dungcathanglthtn261/dungcathanglthtn261/docs/Đề tài.docx

Tên đề tài: Thiết bị đo độ ẩm đất và tự động tưới cây (Smart Irrigation System)

1. Mục tiêu đề tài

Xây dựng hệ thống nhúng điều khiển tưới cây tự động dựa trên vi điều khiển STM32 (ARM Cortex-M), giám sát độ ẩm đất trong khoảng từ 0% đến 100%, tự động kích hoạt/ngừng máy bơm theo ngưỡng cài đặt, hỗ trợ giám sát tại chỗ qua LCD và truyền dữ liệu giám sát từ xa về máy tính qua cổng nối tiếp UART[1][4].

2. Thiết kế phần cứng & Khối ngoại vi (Hardware Prototype)

- Vi điều khiển trung tâm: STM32F4 (hoặc STM32F103 Blue Pill)[4].
- Khối cảm biến (Sensor Interface): Cảm biến độ ẩm đất (Soil Moisture Sensor) đọc giá trị điện áp tương tự qua bộ chuyển đổi ADC[1][4].
- Khối hiển thị (Display): Màn hình LCD 16x02 (hoặc LCD 7-segment) hiển thị độ ẩm hiện tại (%), ngưỡng Set point, chế độ hoạt động và trạng thái máy bơm[1][4].
- Khối giao tiếp người dùng (Buttons): Các nút nhấn được xử lý chống dội (Debounce)[1][4]:
- Nút MODE: Chuyển đổi giữa chế độ Tự động (Auto) và Thủ công (Manual)[4].
- Nút UP / DOWN: Cài đặt ngưỡng độ ẩm tự động tưới (Set point: 0% – 100%)[4].
- Nút PUMP: Bật/Tắt máy bơm thủ công khi ở chế độ Manual[4].
- Khối chấp hành (Actuator): Module Relay điều khiển bật/tắt van từ hoặc máy bơm nước[4].
- Khối truyền thông ngoại vi (Communication): Cổng nối tiếp USART/UART gửi dữ liệu giám sát độ ẩm và trạng thái bơm lên máy tính (sử dụng phần mềm Terminal như Tera Term / Hercules)[1][5].

3. Yêu cầu chức năng chi tiết (Functional Requirements)

- Lấy mẫu & Đo đạc: Đọc giá trị độ ẩm từ cảm biến qua ADC định kỳ mỗi 1000 ms, quy đổi sang tỷ lệ phần trăm (0% – 100%, độ phân giải 1%)[4].
- Thuật toán điều khiển:
- Chế độ Auto: Tự động kích hoạt Relay bật máy bơm khi độ ẩm đất thấp hơn ngưỡng Set point và tắt máy bơm khi độ ẩm đạt ngưỡng[4].
- Chế độ Manual: Bật/Tắt máy bơm trực tiếp thông qua nút nhấn PUMP, không phụ thuộc vào giá trị cảm biến[4].
- Hiển thị tại chỗ: Cập nhật liên tục độ ẩm hiện tại, trạng thái máy bơm (ON/OFF), ngưỡng cài đặt và chế độ (AUTO/MAN) lên màn hình LCD[4].
- Truyền dữ liệu lên PC: Định kỳ truyền gói tin dữ liệu qua UART về máy tính theo định dạng chuẩn (Ví dụ: SOIL: 45% | SET: 60% | MODE: AUTO | PUMP: ON) để ghi log và giám sát[1][5].

4. Kiến trúc phần mềm & Hệ điều hành thời gian thực (FreeRTOS)

Để đáp ứng tiêu chuẩn thiết kế mô-đun hóa, dễ tái sử dụng và quản lý đa nhiệm[1]:

- Phân tầng mã nguồn (Layered Architecture)[1][7]:
- Driver / HAL Layer: Cấu hình thanh ghi / thư viện ngoại vi STM32 (GPIO, ADC, USART, SysTick)[7][8].
- Middleware / Abstraction Layer: Thiết kế các file mảng mô-đun .h/.c độc lập cho từng ngoại vi (soil_sensor.h/.c, lcd16x02.h/.c, button.h/.c, relay_pump.h/.c, uart_comm.h/.c)[6][7].
- Application Layer: Chứa thuật toán điều khiển chính và quản lý máy trạng thái (State Machine)[7].
- Tổ chức tác vụ FreeRTOS (Recommended)[1][2]:
- Task_SensorRead (Chu kỳ 1000 ms): Đọc ADC cảm biến độ ẩm đất và lọc nhiễu[4].
- Task_ButtonProcess (Chu kỳ 20 ms): Quét trạng thái nút nhấn, chống dội và cập nhật chế độ/ngưỡng[4].
- Task_Control (Chu kỳ 100 ms): Thực thi thuật toán so sánh ngưỡng điều khiển Relay bơm[4].
- Task_Display (Chu kỳ 200 ms): Cập nhật thông số lên màn hình LCD 16x02[4].
- Task_UART_Tx (Chu kỳ 1000 ms): Định dạng và gửi gói tin giám sát qua UART về máy tính[1][5].

5. Yêu cầu sản phẩm bàn giao (Deliverables)

- Báo cáo đồ án: Soạn thảo bằng MS Word hoặc LaTeX[3].
- Mô phỏng: Sơ đồ mạch và chương trình mô phỏng hoàn chỉnh trên Proteus Simulation[3][4].
- Mô hình thực nghiệm: Thi công mạch thực tế trên Breadboard hoặc mạch PCB[3][4].
