dungcathanglthtn261/dungcathanglthtn261/docs/General requirements.pdf

Student can suggest a project; the general requirements are as follow: The system has a display (character LCD, OLED …)
The system has buttons.
The system interface with sensor (temperature, humidity…) or external module like RFID reader.
The system needs to store information to SDCARD or communicate with external device (computer via serial port, server via WIFI).
Software is divided in to layers, with design-for-reuse in mind.
Using FreeRTOS is recommended.
