dungcathanglthtn261/dungcathanglthtn261/docs/block-diagram/Blockdiagram.drawio.png

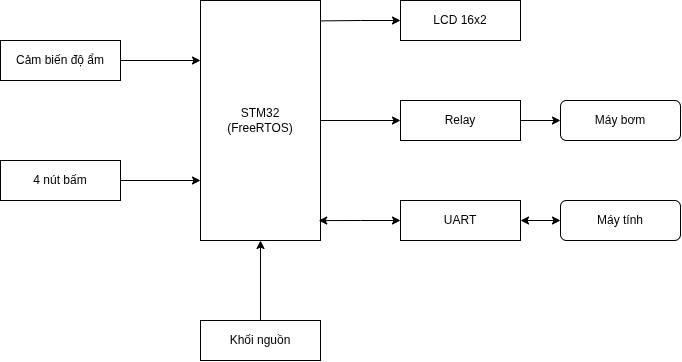
docs/block-diagram/Blockdiagram.drawio.png
