dungcathanglthtn261/dungcathanglthtn261/docs/flowcharts/0_main.png

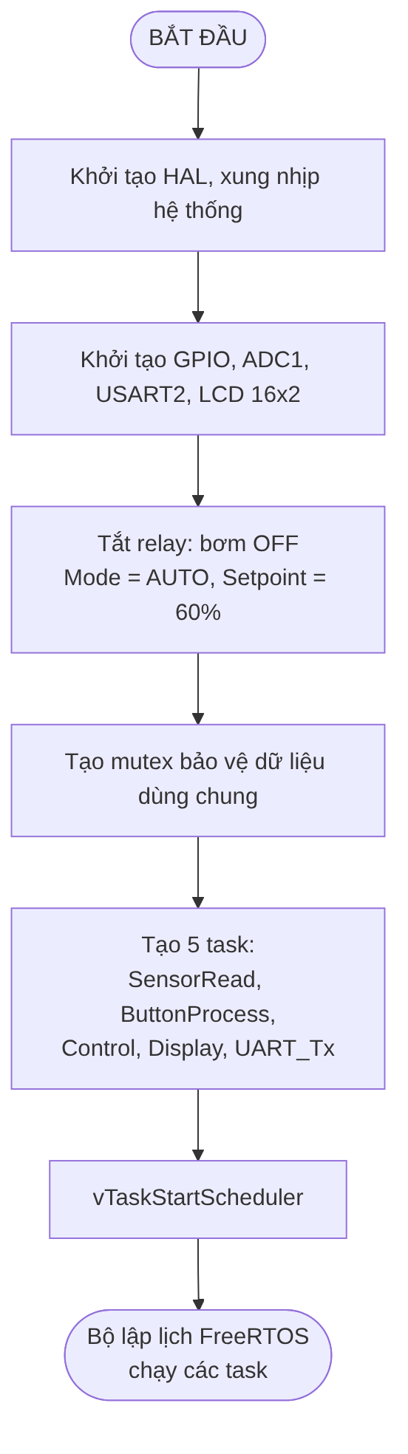
docs/flowcharts/0_main.png
