dungcathanglthtn261/dungcathanglthtn261/docs/flowcharts/1_sensor.png

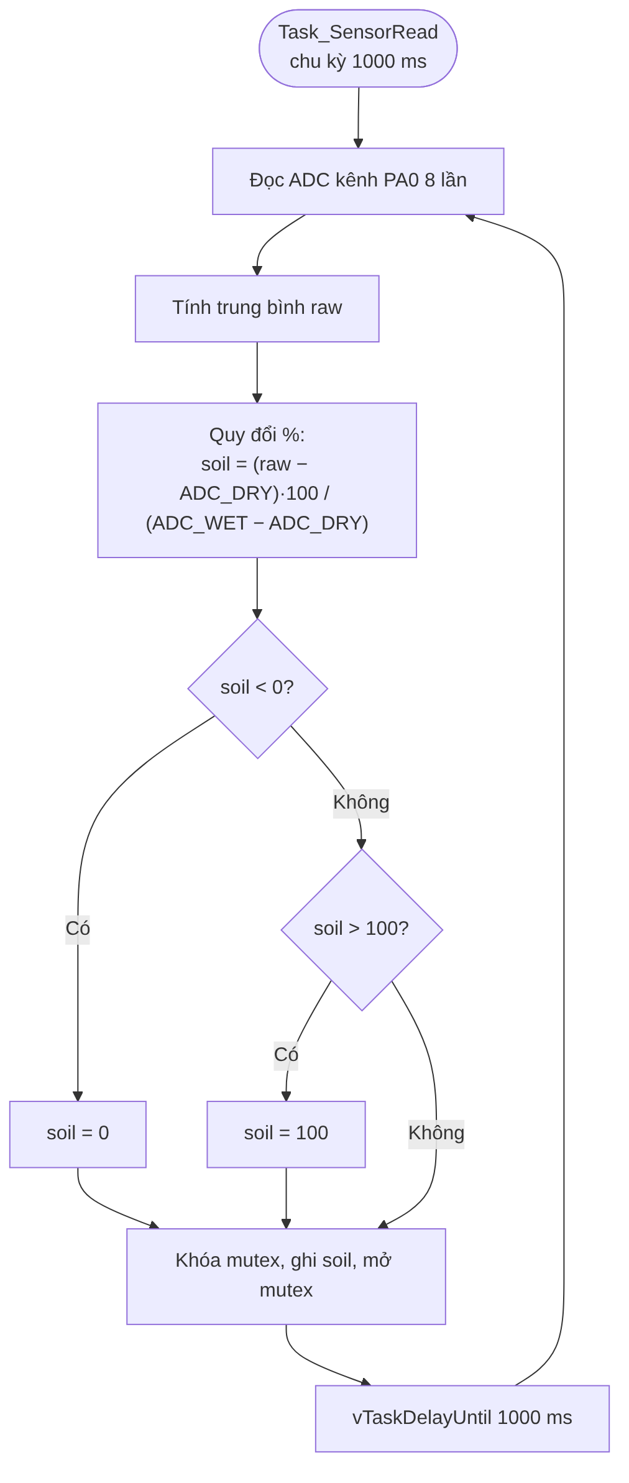
docs/flowcharts/1_sensor.png
