dungcathanglthtn261/dungcathanglthtn261/docs/flowcharts/2_button.png

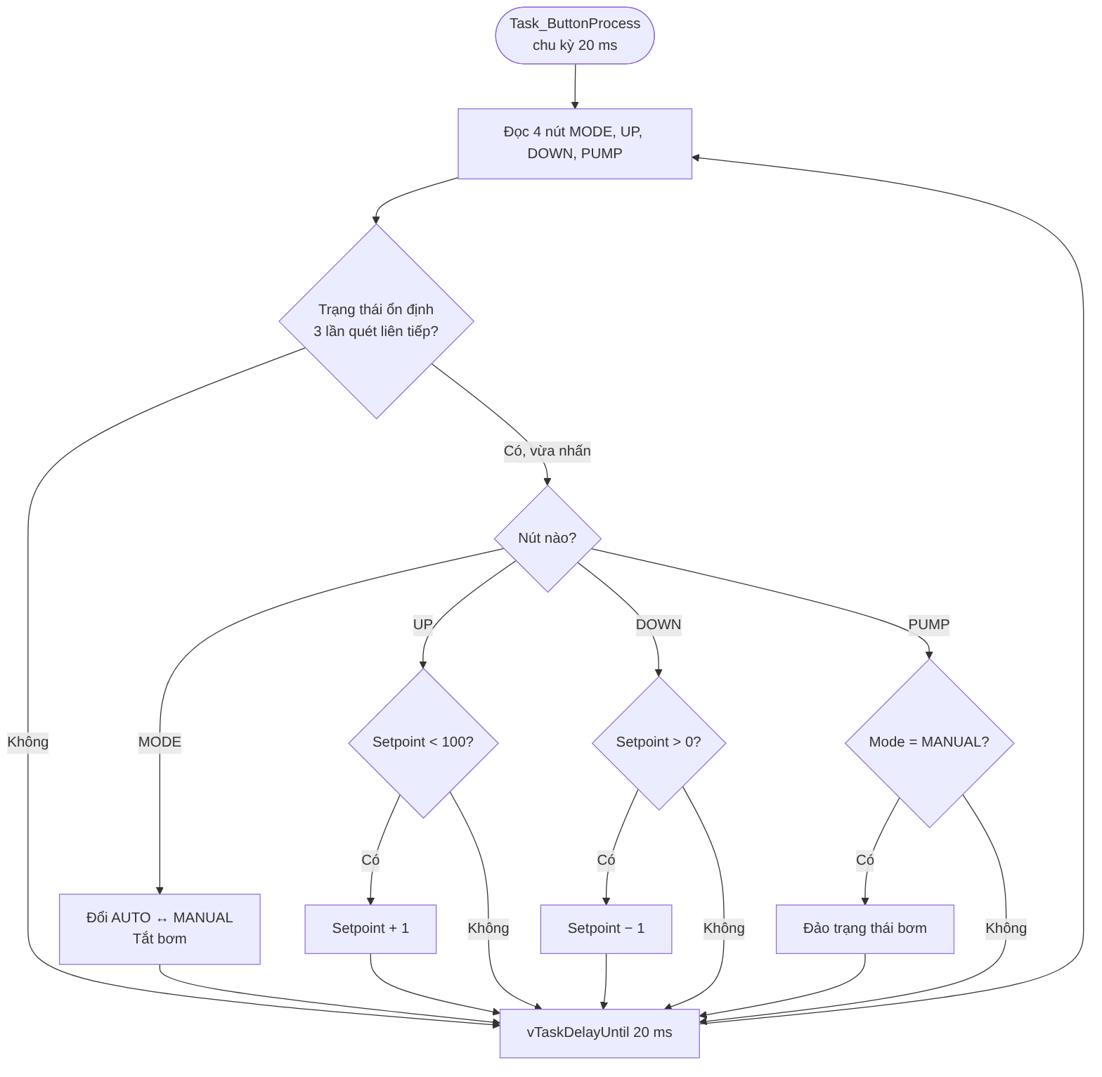
docs/flowcharts/2_button.png
