dungcathanglthtn261/dungcathanglthtn261/docs/flowcharts/3_control.png

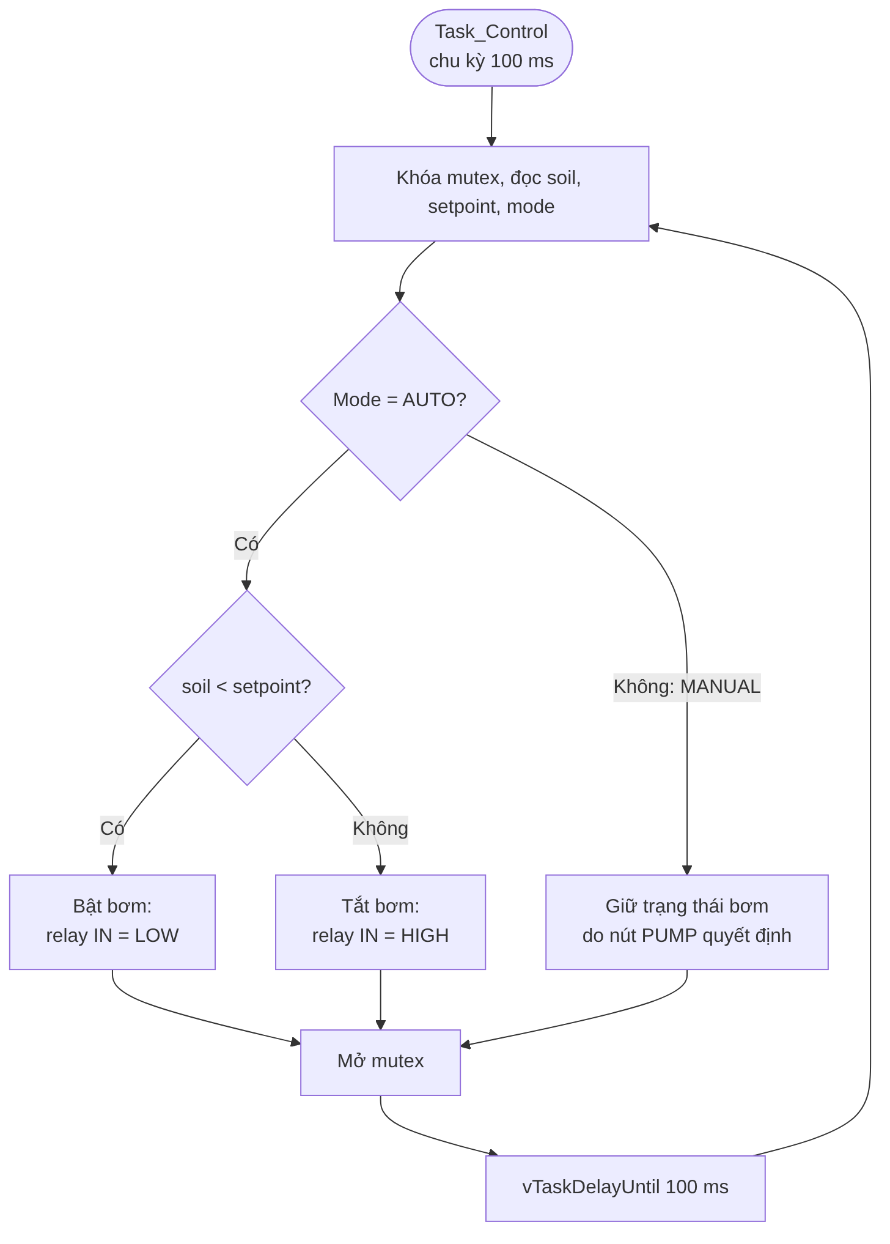
docs/flowcharts/3_control.png
