dungcathanglthtn261/dungcathanglthtn261/docs/flowcharts/4_display.png

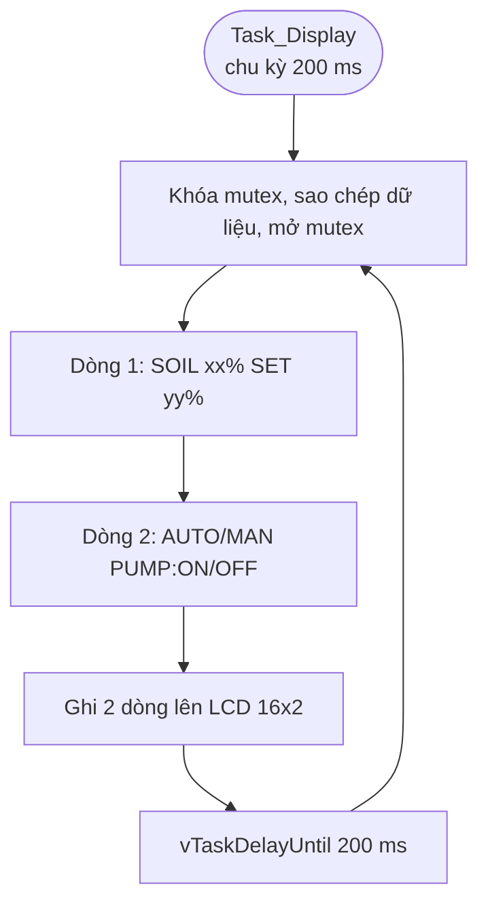
docs/flowcharts/4_display.png
