dungcathanglthtn261/dungcathanglthtn261/docs/flowcharts/5_uart.png

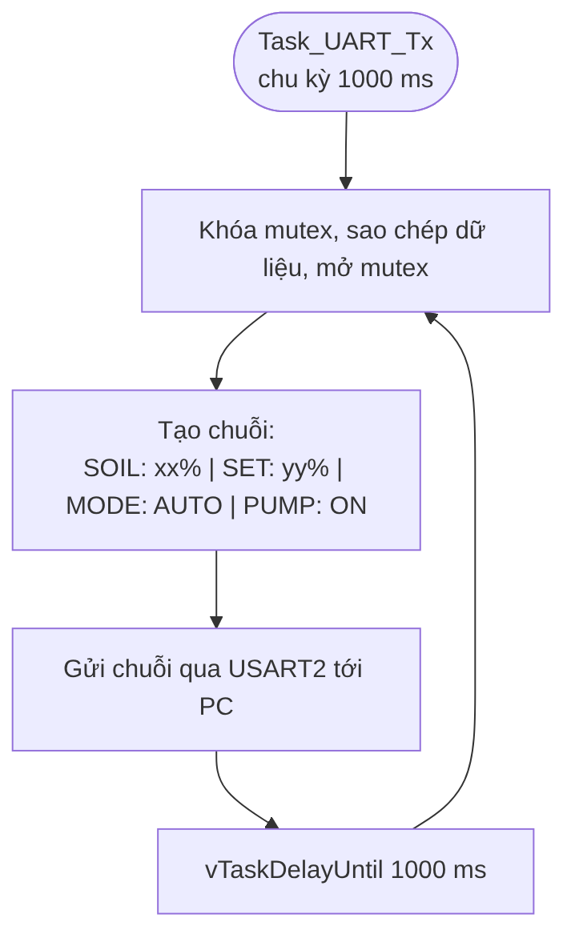
docs/flowcharts/5_uart.png
