dungcathanglthtn261/dungcathanglthtn261/hardware/images/pcb_bottom_gnd.png

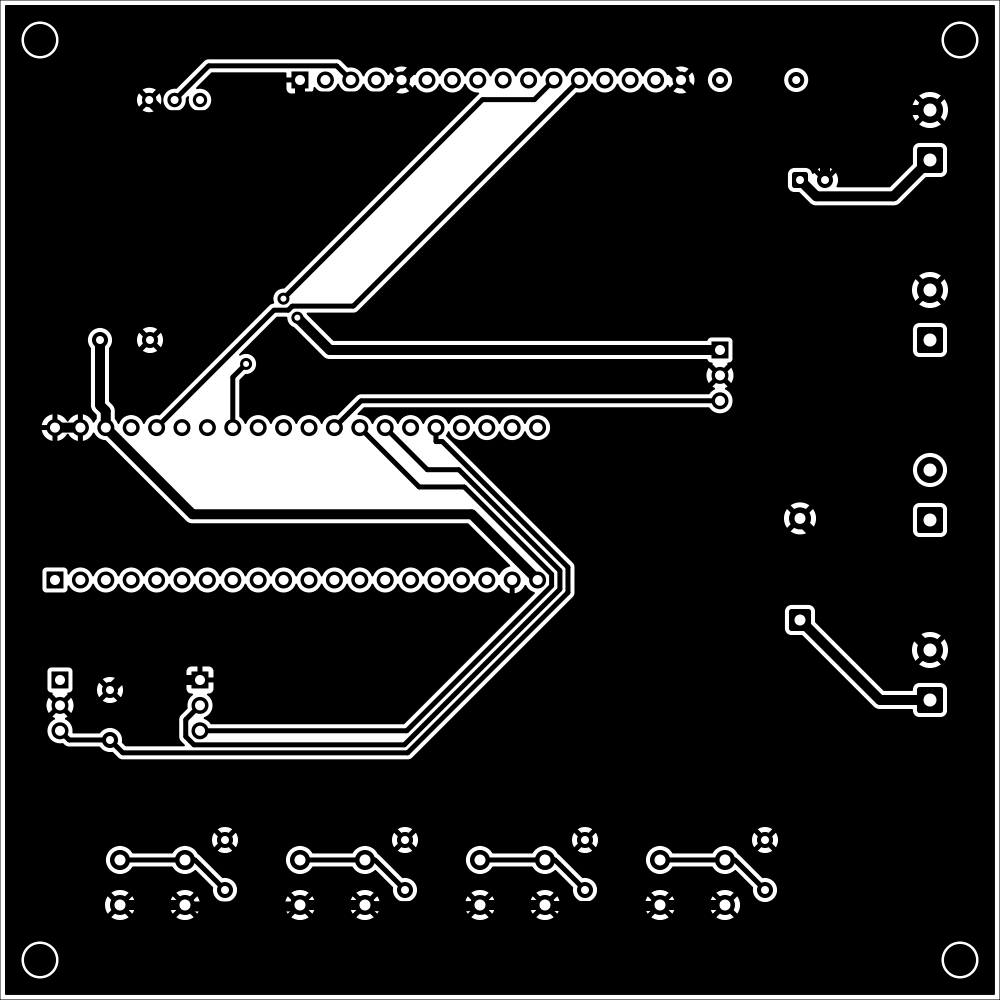
hardware/images/pcb_bottom_gnd.png
