dungcathanglthtn261/dungcathanglthtn261/hardware/images/schematic_preview.png

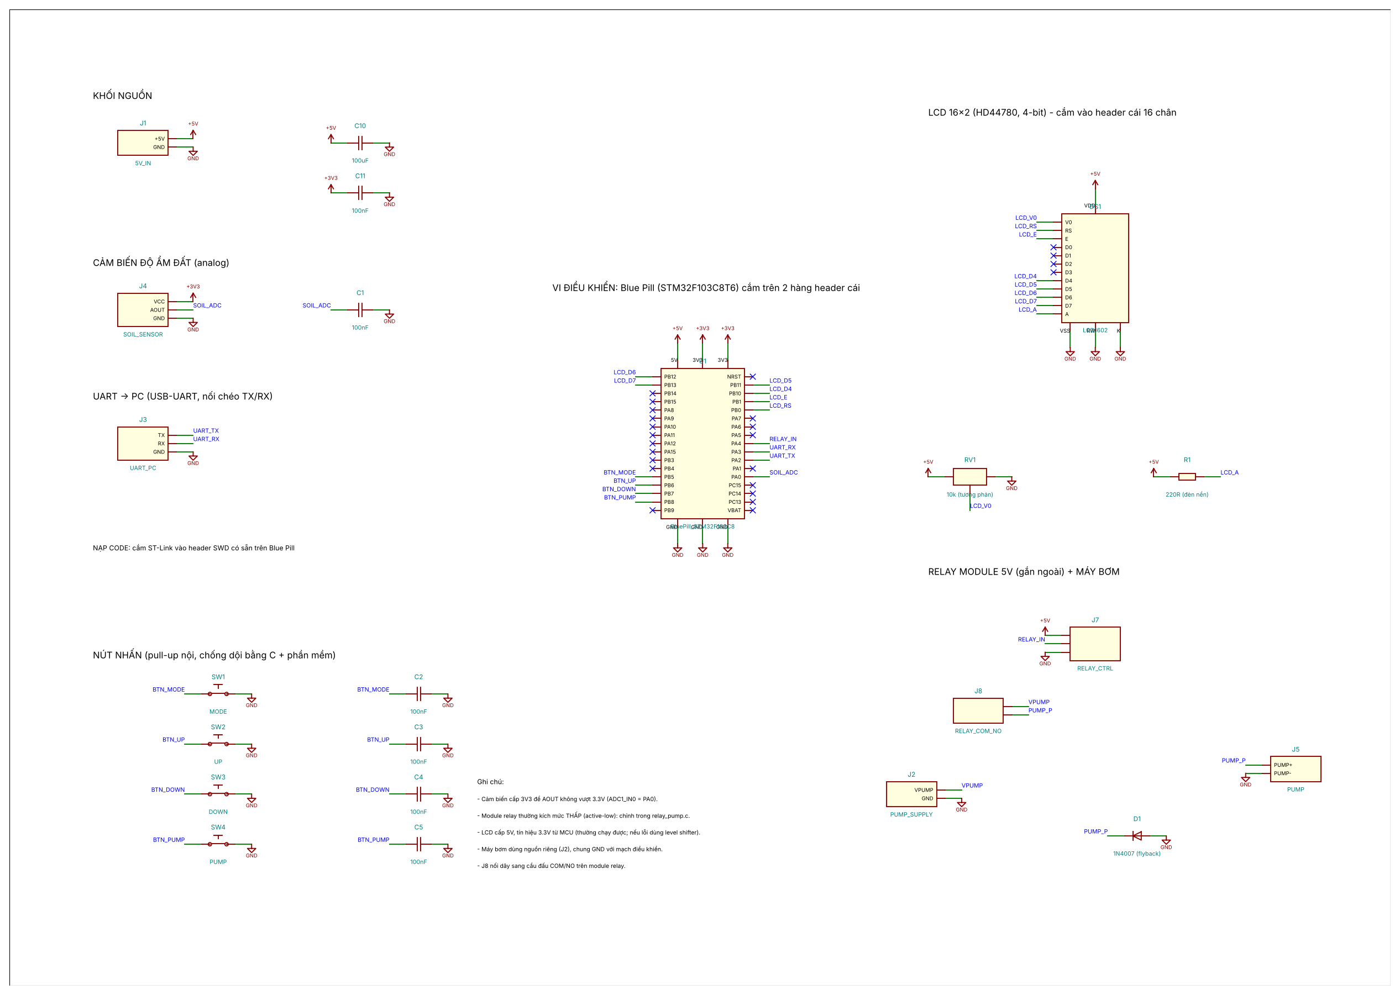
hardware/images/schematic_preview.png
