dungcathanglthtn261/dungcathanglthtn261/docs/test/Kịch bản kiểm thử.xlsx

Sheet: Tổng hợp
TỔNG HỢP KẾT QUẢ KIỂM THỬ
Tự tính từ sheet "Kịch bản test" – không cần điền.
Kịch bản | Số bước | Đã điền | Đạt | Không đạt | Kết luận
Chế độ AUTO | 4 | 0 | 0 | 0 | Chưa test xong
Chế độ MANUAL | 5 | 0 | 0 | 0 | Chưa test xong
Đổi ngưỡng | 4 | 0 | 0 | 0 | Chưa test xong
Tổng | 13 | 0 | 0 | 0 | Chưa test xong
Môi trường test: | Mokxi (bluepill) / Mạch thật – ghi rõ
Người test / ngày:

Sheet: Kịch bản test
KỊCH BẢN KIỂM THỬ – SMART IRRIGATION SYSTEM (mô phỏng Mokxi / mạch thật)
Ô nền vàng là ô cần điền. Cột "Đạt?" chọn từ danh sách (Đạt / Không đạt). Ngưỡng mặc định khi khởi động: 60%, chế độ AUTO.
Mã | Kịch bản | Bước | Thao tác | Kết quả mong đợi | Kết quả thực tế | Đạt? | Ảnh minh chứng | Ghi chú
KB1 – Chế độ AUTO: Kiểm tra thuật toán điều khiển chính
KB1-1 | Chế độ AUTO | 1 | Bấm Run, giữ ngưỡng mặc định 60% | LCD hiện "AUTO"; Serial in đúng 1 dòng/giây |  |  | Không bắt buộc
KB1-2 | Chế độ AUTO | 2 | Chỉnh cảm biến về đất khô (độ ẩm < 60%) | Trong ~1 s: relay đóng, bơm chạy; LCD và Serial báo PUMP: ON |  |  | Bắt buộc: LCD + Serial
KB1-3 | Chế độ AUTO | 3 | Chỉnh cảm biến về đất ướt (độ ẩm ≥ 60%) | Bơm tắt; LCD và Serial báo PUMP: OFF |  |  | Bắt buộc: LCD + Serial
KB1-4 | Chế độ AUTO | 4 | Bấm nút PUMP | Không có gì thay đổi (ở AUTO nút PUMP bị bỏ qua) |  |  | Không bắt buộc
KB2 – Chế độ MANUAL: Kiểm tra điều khiển tay và chuyển chế độ
KB2-1 | Chế độ MANUAL | 1 | Ở AUTO khi bơm đang chạy, bấm MODE | Bơm tắt ngay; LCD "MAN"; Serial MODE: MANUAL |  |  | Bắt buộc
KB2-2 | Chế độ MANUAL | 2 | Bấm PUMP | Bơm chạy |  |  | Không bắt buộc
KB2-3 | Chế độ MANUAL | 3 | Chỉnh đất về ướt | Bơm VẪN chạy (MANUAL bỏ qua cảm biến) |  |  | Bắt buộc
KB2-4 | Chế độ MANUAL | 4 | Bấm PUMP | Bơm tắt |  |  | Không bắt buộc
KB2-5 | Chế độ MANUAL | 5 | Bấm MODE | Quay lại AUTO; bơm được tính lại theo độ ẩm |  |  | Không bắt buộc
KB3 – Đổi ngưỡng: Kiểm tra nút UP/DOWN và ảnh hưởng của ngưỡng lên điều khiển
KB3-1 | Đổi ngưỡng | 1 | Ở AUTO, chỉnh độ ẩm ~50%, ngưỡng 60% | Bơm chạy (50 < 60) |  |  | Bắt buộc (ảnh "trước")
KB3-2 | Đổi ngưỡng | 2 | Bấm DOWN đến khi ngưỡng còn 49% | Mỗi lần bấm giảm đúng 1%; ngưỡng xuống dưới độ ẩm thì bơm tự tắt |  |  | Bắt buộc (ảnh "sau")
KB3-3 | Đổi ngưỡng | 3 | Bấm UP lên lại 55% | Bơm chạy trở lại |  |  | Không bắt buộc
KB3-4 | Đổi ngưỡng | 4 | Bấm UP liên tục tới 100% rồi bấm thêm; làm tương tự DOWN về 0% | Ngưỡng dừng ở 100% và 0%, không vượt quá |  |  | Không bắt buộc

Sheet: Số liệu mạch thật
SỐ LIỆU ĐO TRÊN MẠCH THẬT (GĐ4) – dùng cho phần sai số trong báo cáo
Ô nền vàng: điền khi đo. Cột xám tự tính. Dòng "Ví dụ" chỉ minh họa cách điền – xóa đi khi có số liệu thật.
Hằng số hiệu chuẩn
ADC_DRY (đất khô → 0%) | 3164 | Nguồn: hằng số trong sketch.ino (theo cảm biến mô phỏng: 2.55 V khô, 1.27 V ướt). Thay bằng giá trị đo khi hiệu chuẩn.
ADC_WET (đất ướt → 100%) | 1576
Điện áp tham chiếu ADC (V) | 3.3
Độ phân giải ADC (mức) | 4095
Lần đo | Kịch bản | Trạng thái đất | Điện áp AOUT đo (V) | Giá trị ADC (tính) | Độ ẩm tính theo công thức (%) | Độ ẩm hệ thống hiển thị (%) | Sai số (%) | Thời gian đáp ứng (s) | Ghi chú
Ví dụ | Chế độ AUTO | Đất khô | 2.4 | 2978 | 11.7 | 12 | 0.3 | 1 | Dòng minh họa – xóa khi có số liệu thật
1
2
3
4
5
6
7
8
9
10
11
12
13
14
15
Sai số trung bình (%)
Thời gian đáp ứng trung bình (s)
(Trung bình không tính dòng "Ví dụ".)
