dungcathanglthtn261/dungcathanglthtn261/hardware/kicad/smart_irrigation.kicad_pcb

## KiCad design hardware/kicad/smart_irrigation.kicad_pcb (2026-11-06)

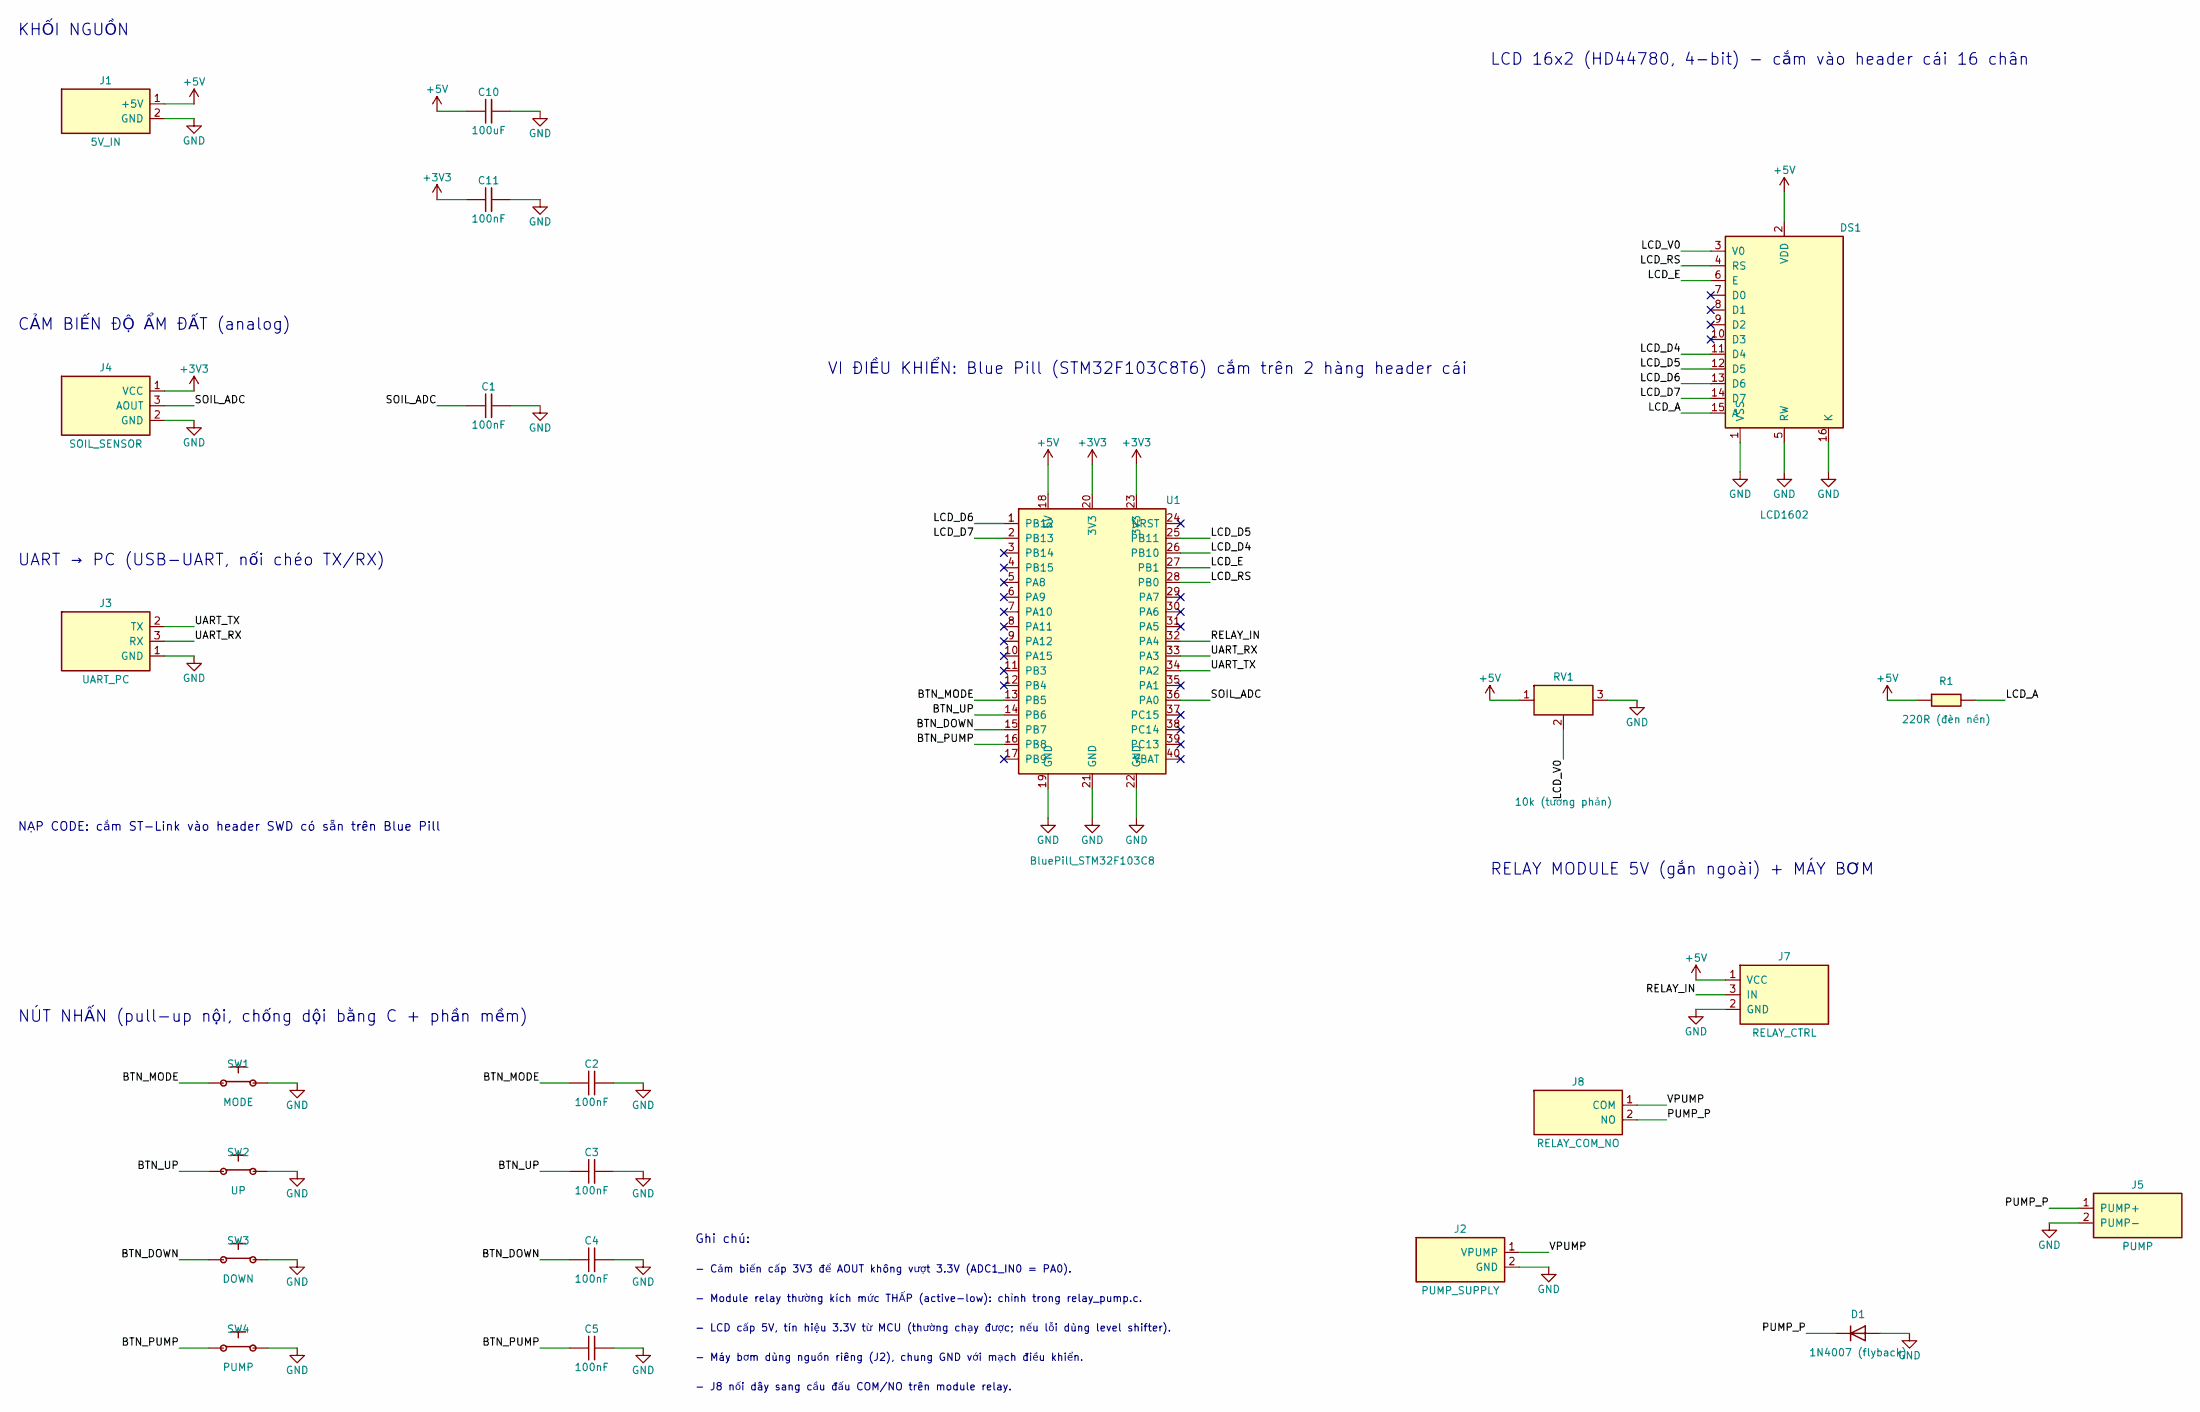
[picture p11: schematic smart_irrigation.kicad_sch, Smart Irrigation System - Schematic]

Parts:
C1, C2, C3, C4, C5, C11: 100nF; C_Disc_D5.0mm_W2.5mm_P5.00mm
C10: 100uF; CP_Radial_D6.3mm_P2.50mm
D1: 1N4007 (flyback); D_DO-41_SOD81_P10.16mm_Horizontal
DS1: LCD1602; PinSocket_1x16_P2.54mm_Vertical
J1: 5V_IN; TerminalBlock_Phoenix_MKDS-1,5-2_1x02_P5.00mm_Horizontal
J2: PUMP_SUPPLY; TerminalBlock_Phoenix_MKDS-1,5-2_1x02_P5.00mm_Horizontal
J3: UART_PC; PinHeader_1x03_P2.54mm_Vertical
J4: SOIL_SENSOR; PinHeader_1x03_P2.54mm_Vertical
J5: PUMP; TerminalBlock_Phoenix_MKDS-1,5-2_1x02_P5.00mm_Horizontal
J7: RELAY_CTRL; PinHeader_1x03_P2.54mm_Vertical
J8: RELAY_COM_NO; TerminalBlock_Phoenix_MKDS-1,5-2_1x02_P5.00mm_Horizontal
R1: 220R (đèn nền); R_Axial_DIN0207_L6.3mm_D2.5mm_P7.62mm_Horizontal
RV1: 10k (tương phản); Potentiometer_Bourns_3296W_Vertical
SW1: MODE; SW_PUSH_6mm
SW2: UP; SW_PUSH_6mm
SW3: DOWN; SW_PUSH_6mm
SW4: PUMP; SW_PUSH_6mm
U1: BluePill_STM32F103C8; BluePill_Socket

Connections:
+3V3: C11.1, J4.1 (VCC), U1.20 (3V3), U1.23 (3V3)
+5V: C10.1, DS1.2 (VDD), J1.1 (+5V), J7.1 (VCC), R1.1, RV1.1, U1.18 (5V)
BTN_DOWN: C4.1, SW3.1, U1.15 (PB7)
BTN_MODE: C2.1, SW1.1, U1.13 (PB5)
BTN_PUMP: C5.1, SW4.1, U1.16 (PB8)
BTN_UP: C3.1, SW2.1, U1.14 (PB6)
GND: C1.2, C2.2, C3.2, C4.2, C5.2, C10.2, C11.2, D1.2 (A), DS1.1 (VSS), DS1.5 (RW), DS1.16 (K), J1.2 (GND), J2.2 (GND), J3.1 (GND), J4.2 (GND), J5.2 (PUMP-), J7.2 (GND), RV1.3, SW1.2, SW2.2, SW3.2, SW4.2, U1.19 (GND), U1.21 (GND), U1.22 (GND)
LCD_A: DS1.15 (A), R1.2
LCD_D4: DS1.11 (D4), U1.26 (PB10)
LCD_D5: DS1.12 (D5), U1.25 (PB11)
LCD_D6: DS1.13 (D6), U1.1 (PB12)
LCD_D7: DS1.14 (D7), U1.2 (PB13)
LCD_E: DS1.6 (E), U1.27 (PB1)
LCD_RS: DS1.4 (RS), U1.28 (PB0)
LCD_V0: DS1.3 (V0), RV1.2 (W)
PUMP_P: D1.1 (K), J5.1 (PUMP+), J8.2 (NO)
RELAY_IN: J7.3 (IN), U1.32 (PA4)
SOIL_ADC: C1.1, J4.3 (AOUT), U1.36 (PA0)
UART_RX: J3.3 (RX), U1.33 (PA3)
UART_TX: J3.2 (TX), U1.34 (PA2)
VPUMP: J2.1 (VPUMP), J8.1 (COM)

Notes on the sheet:
KHỐI NGUỒN
CẢM BIẾN ĐỘ ẨM ĐẤT (analog)
UART → PC (USB-UART, nối chéo TX/RX)
NẠP CODE: cắm ST-Link vào header SWD có sẵn trên Blue Pill
NÚT NHẤN (pull-up nội, chống dội bằng C + phần mềm)
VI ĐIỀU KHIỂN: Blue Pill (STM32F103C8T6) cắm trên 2 hàng header cái
LCD 16x2 (HD44780, 4-bit) - cắm vào header cái 16 chân
RELAY MODULE 5V (gắn ngoài) + MÁY BƠM
Ghi chú:
- Cảm biến cấp 3V3 để AOUT không vượt 3.3V (ADC1_IN0 = PA0).
- Module relay thường kích mức THẤP (active-low): chỉnh trong relay_pump.c.
- LCD cấp 5V, tín hiệu 3.3V từ MCU (thường chạy được; nếu lỗi dùng level shifter).
- Máy bơm dùng nguồn riêng (J2), chung GND với mạch điều khiển.
- J8 nối dây sang cầu đấu COM/NO trên module relay.

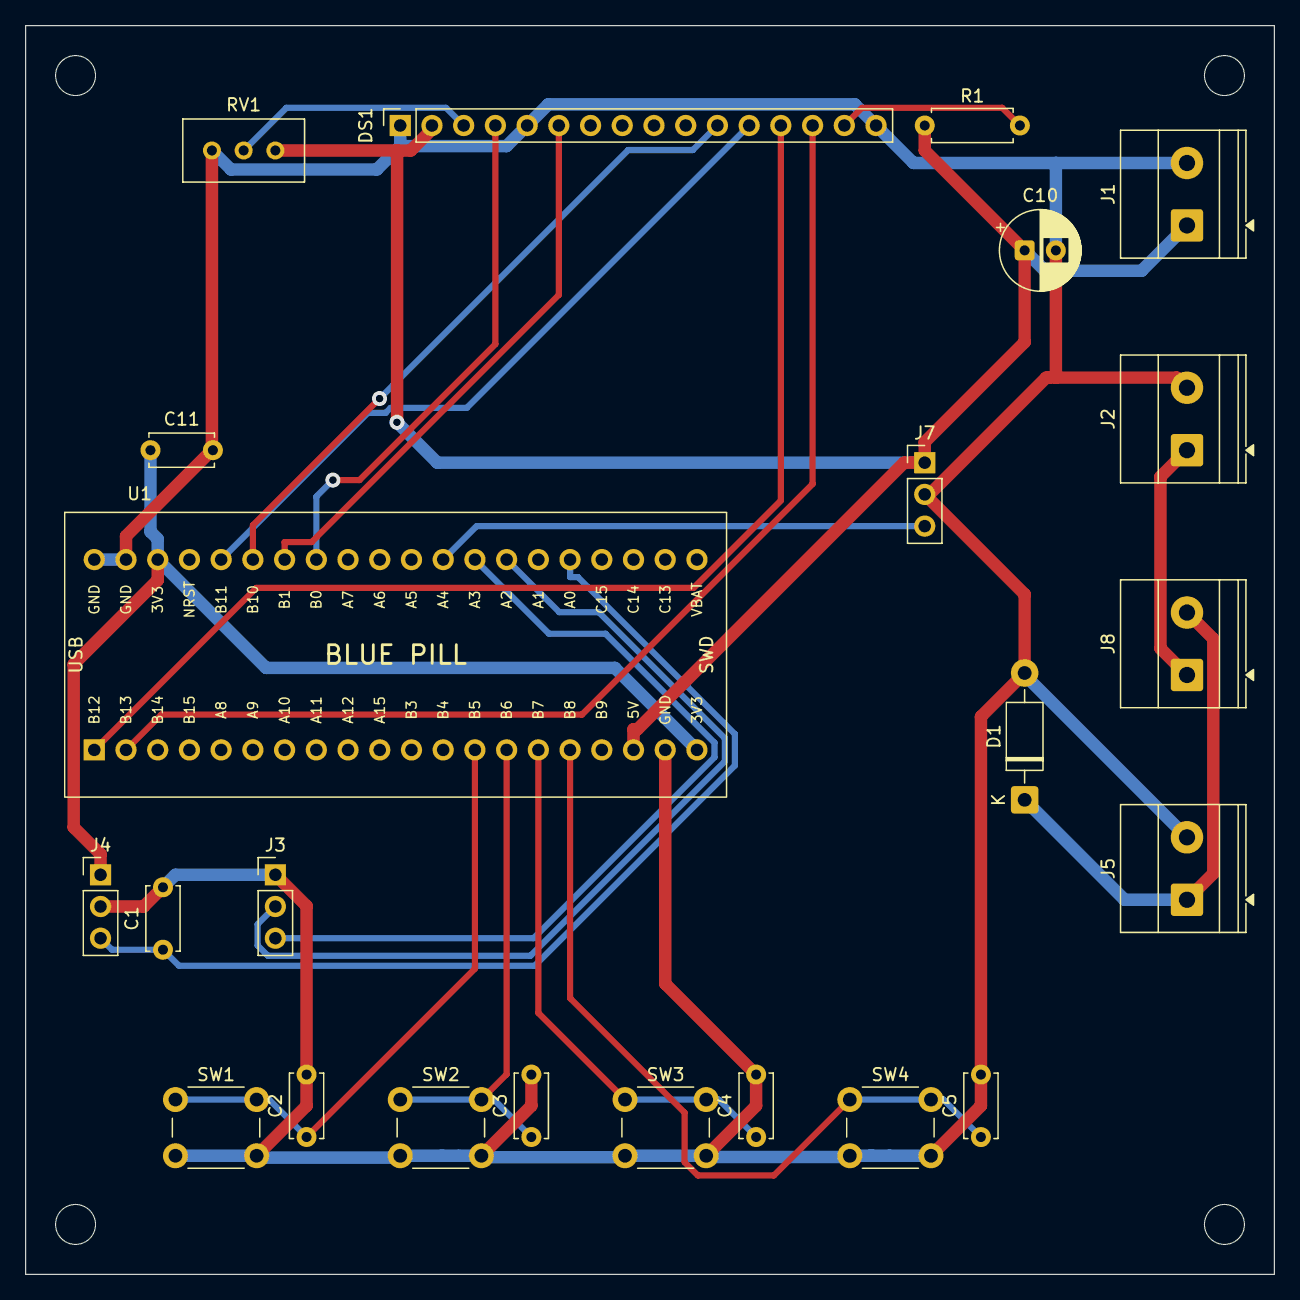
[picture p12: board smart_irrigation.kicad_pcb from above]

Board: 2 copper layers, 100.0 x 100.0 mm, 27 parts (0 on the bottom side), 21 nets.

Other parts of the board:
MH1, MH2, MH3, MH4: M3; MountingHole_3.2mm_M3
