dungcathanglthtn261/dungcathanglthtn261/(commit log)

2026-11-06 Add Smart Irrigation System project (hardware, simulation, docs)
    - KiCad schematic + 10x10 cm PCB, Blue Pill socketed on 1x20 female headers
    - Project symbol/footprint libraries (BluePill_Socket)
    - Mokxi/Wokwi simulation: diagram.json + Arduino sketch
    - Project brief, requirements, task sheet and block diagram
    Claude-Session: https://claude.ai/code/session_01Swvh67yDHj4p2B3b1d9y5w
    [Bài tập lớn.xlsx, smart_irrigation.kicad_pcb, smart_irrigation.kicad_sch]
2026-11-06 Tidy Mokxi simulation wiring
    Chain ground returns between neighbouring parts, drop the simulator-only
    backlight resistor and ground the pump circuit through the relay so the
    auto-laid-out Mokxi canvas has fewer long wires. Validated with Mokxi
    (0 errors).
    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
2026-11-06 Re-layout Mokxi circuit: grouped parts, orthogonal non-overlapping wires
    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
2026-11-06 Add saved Mokxi project link and Mokxi-calibrated sketch
    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
2026-11-06 Add FreeRTOS firmware (app + middleware), test plan, flowcharts
    [Kịch bản kiểm thử.xlsx]
